cburgess5294/Arduino-Teensy/README.md

# Arduino-Teensy
Repository for files related to the Arduino-Teensy v4
