cburgess5294/Arduino-Teensy/v4.4/BOM_Arduino-Teensy-v44_PLUS_ESP-12E_4LAYER.xlsx

Designator | Manufacturer Part Number |  | Quantity
C1,C5 | EEE-1CA470SP |  | 2
C2 | TAJB106M006RNJ |  | 1
C3 | GRM188R70J103KA01D |  | 1
C6 | TAJR106M006RNJ (TANTALUM) | 08056D106KAT4A (CERAMIC) | 1
C7 | GRM188R70J104KA01D |  | 1
C8 | TMCMB0J227MTRF | F930G227MBA | 1
C9,C10 | 885012106010 |  | 2
D1,D3 | SS1P3LHM3/84A | SS1P3L-M3/84A | 2
D2 | CD1206-S01575 |  | 1
D13 | APT2012SRCPRV |  | 1
ESP-PGM,ESP-RST,HC-PGM | ADTSM62KV | PTS645SM43SMTR92 LFS | 3
F1,F2 | 0ZCJ0050FF2G |  | 2
IC1 | LM2734YMKX/NOPB |  | 1
IC2 | AP7215-33YG-13 |  | 1
L1 | MH2029-300Y |  | 1
L2 | SRR0604-100ML |  | 1
LED10,RXD1,RXD2,RXD3,TXD1,TXD2,TXD3 | APT2012SYCK |  | 7
PWR | APT2012SGC |  | 1
Q1,Q2,Q3 | BSD223PH6327XTSA1 |  | 3
Q4 | FDN340P |  | 1
R1 | RC0603JR-071KL |  | 1
R2,R4 | ESR03EZPJ103 |  | 2
R3 | RR0816P-5232-D-70C |  | 1
RESET | ADTSM62RV |  | 1
RN1,RN7 | CAT16-102J4LF |  | 2
RN3 | CAT16-103J4LFCT-ND |  | 1
RN4,RN5,RN8 | EXB-34V103JV |  | 3
RN6 | CAT16-223J4LF |  | 1
RN9 | EXB-34V223JV |  | 1
POGO-PIN | 0906-1-15-20-75-14-11-0 |  | 1
14-PIN SMD MALE HEADER | 15-91-2140 |  | 1
RTC CRYSTAL | CFS206-32.768KDZF-UB |  | 1
COIN CELL HOLDER | BAT-HLD-001 |  | 1
2.1mm barrel jack | PJ-002A |  | 1
