cburgess5294/Arduino-Teensy/Arduino-Teensy-v421_PLUS_ESP-12E.pdf

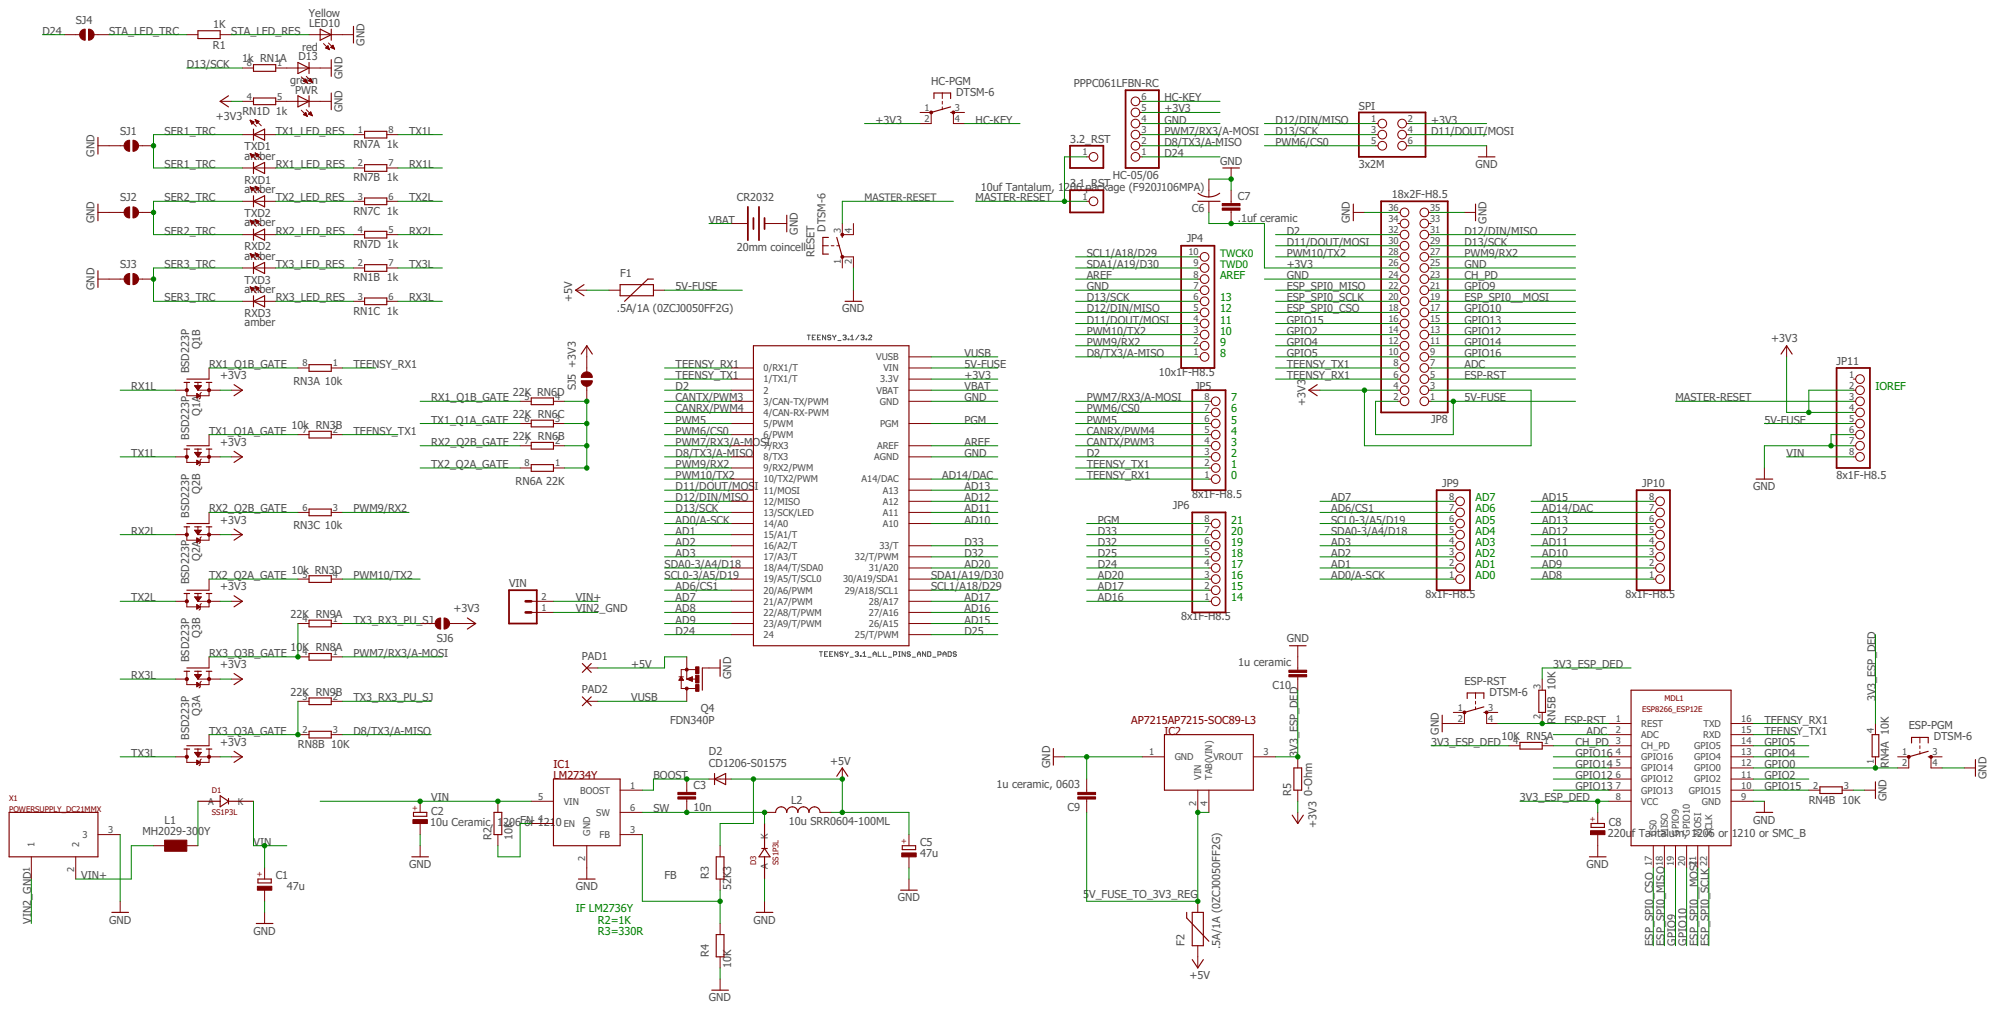
[picture p1: page 1]
