cburgess5294/Arduino-Teensy/v5/Arduino-Teensy-v51_PLUS_ESP-12E_4LAYER-BRD.pdf

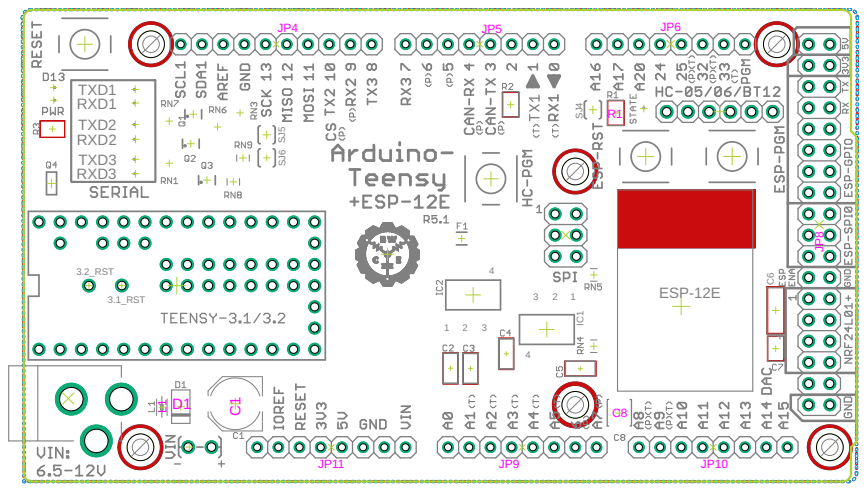
[picture p2: page 1]
