cburgess5294/Arduino-Teensy/v5/Arduino-Teensy-v51_PLUS_ESP-12E_4LAYER-SCH.pdf

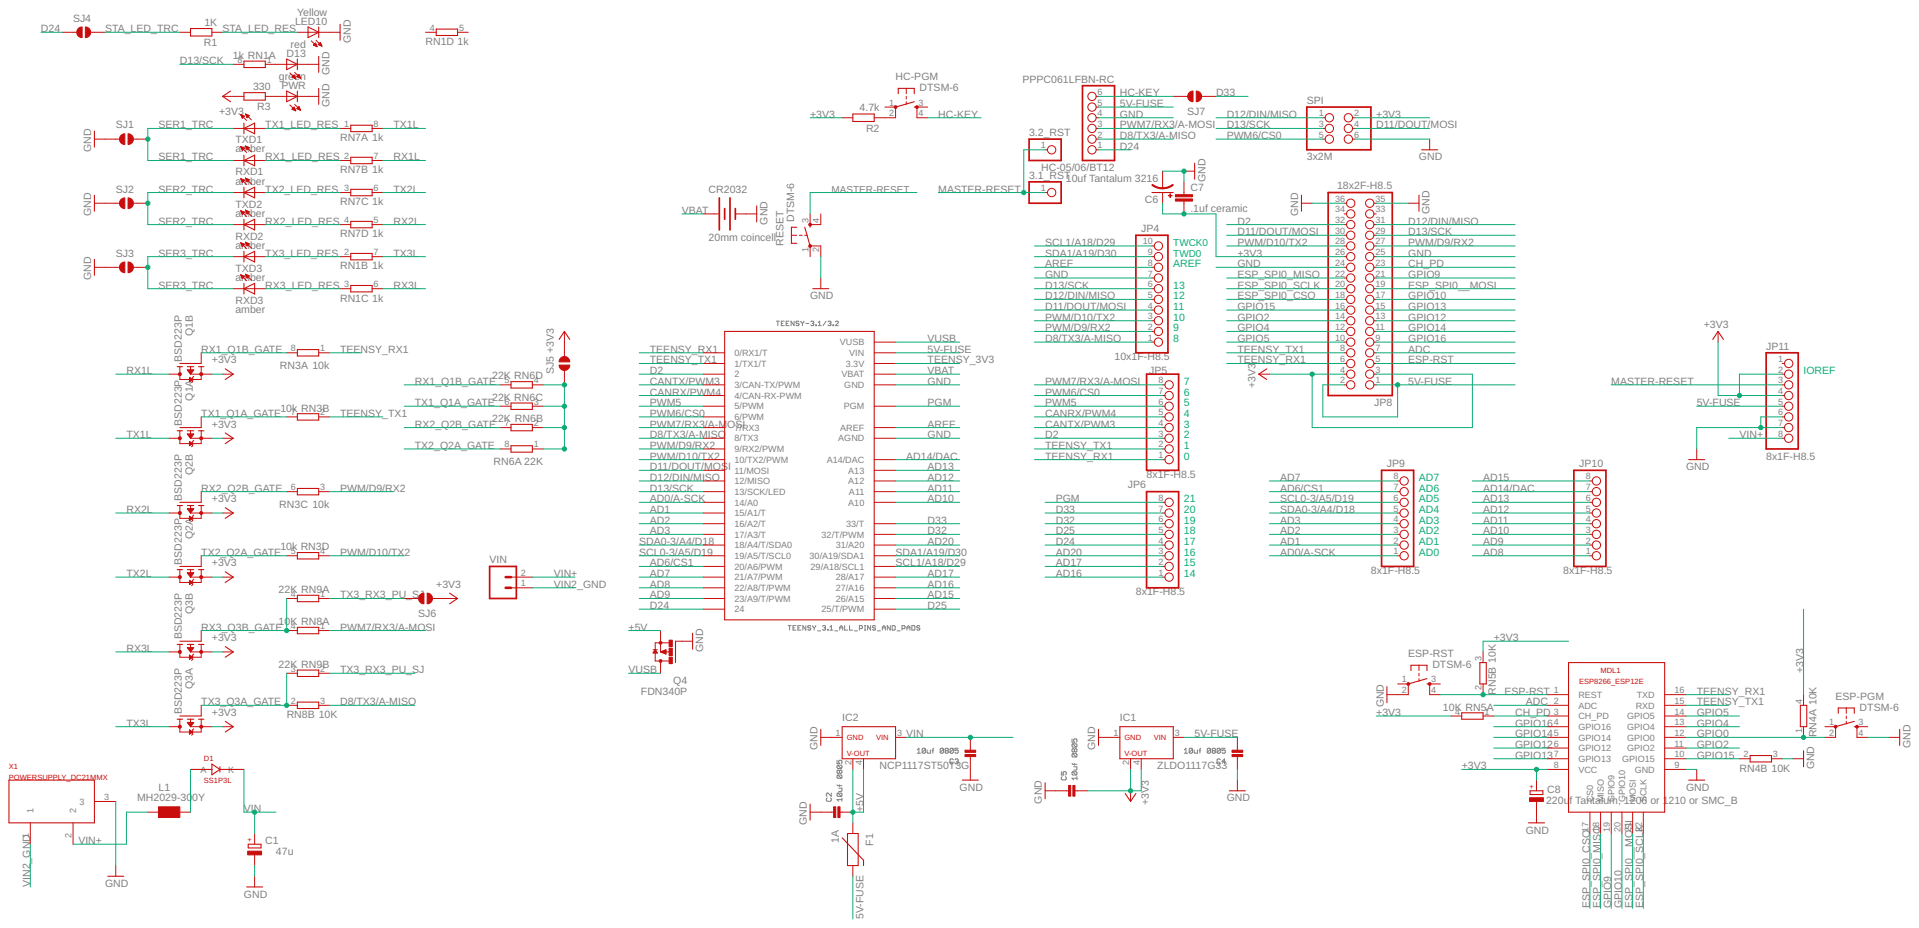
[picture p3: page 1]
