cburgess5294/Arduino-Teensy/v4.3/Arduino-Teensy-v43_PLUS_ESP-12E_BRD.pdf

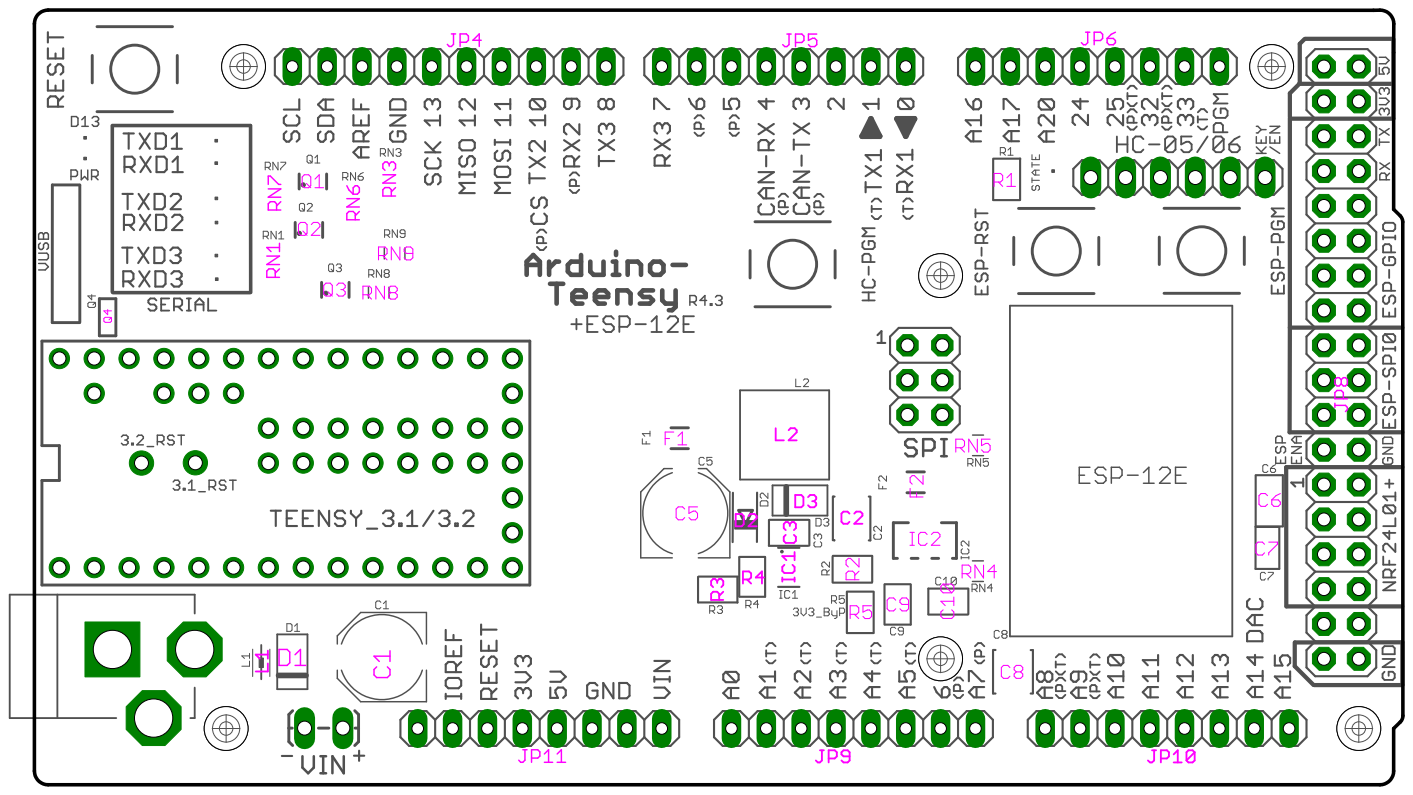
[picture p4: page 1]
