cburgess5294/Arduino-Teensy/v4.4/Arduino-Teensy-v44_PLUS_ESP-12E_4LAYER_BRD.pdf

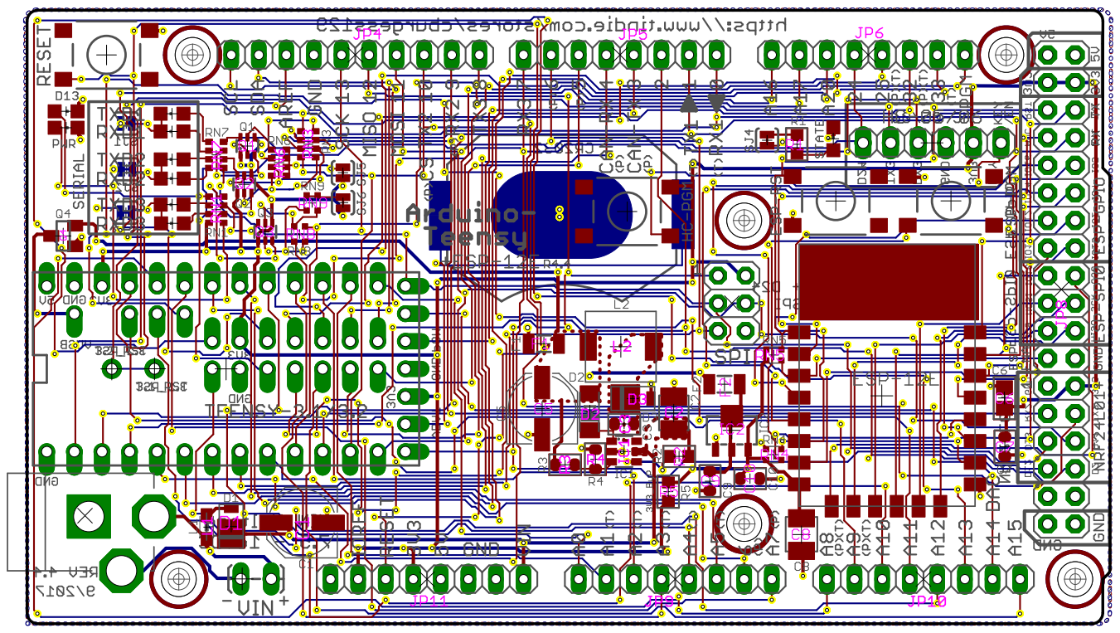
[picture p5: page 1]
