cburgess5294/Arduino-Teensy/v4.3/Arduino-Teensy-v43_PLUS_ESP-12E_SCH.pdf

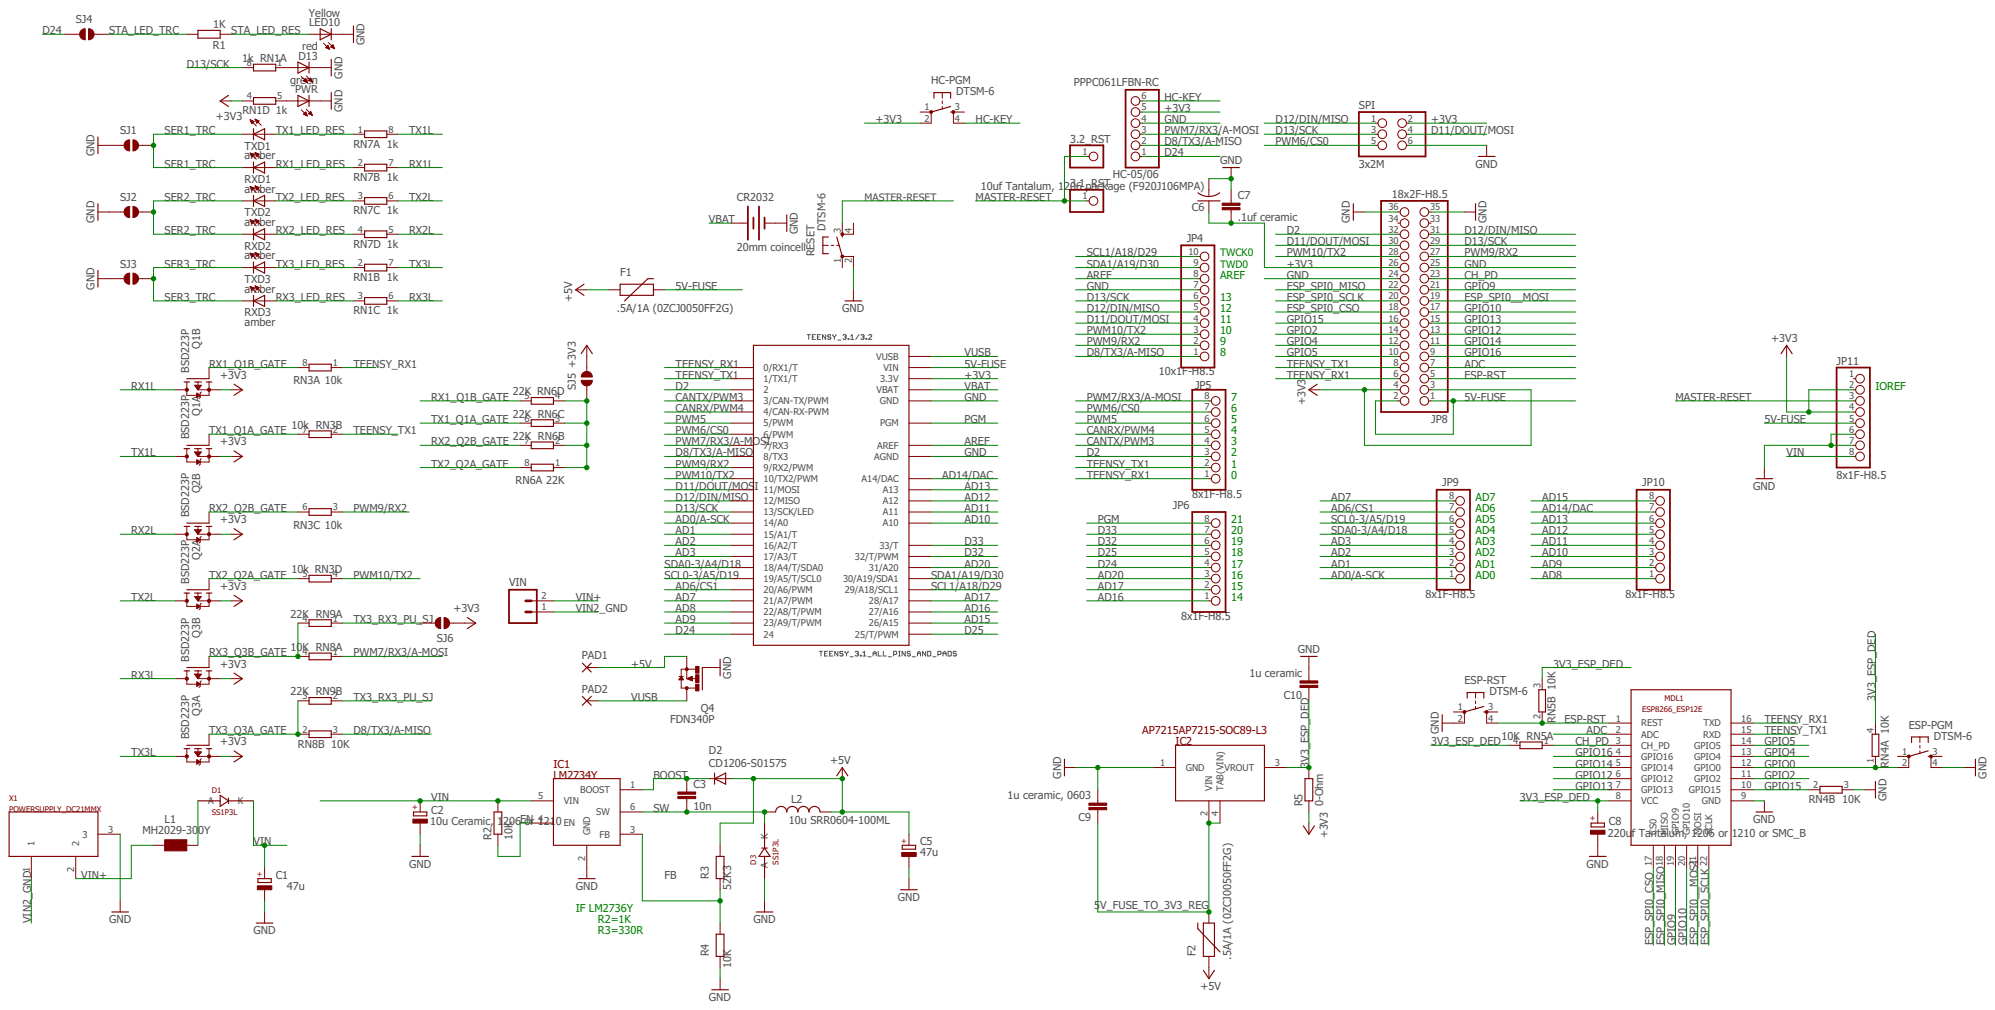
[picture p8: page 1]
