cburgess5294/Arduino-Teensy/v5/Arduino-Teensy-v5_PLUS_ESP-12E_4LAYER.brd

## EAGLE design v5/Arduino-Teensy-v5_PLUS_ESP-12E_4LAYER.brd (2019-08-05, an earlier design)

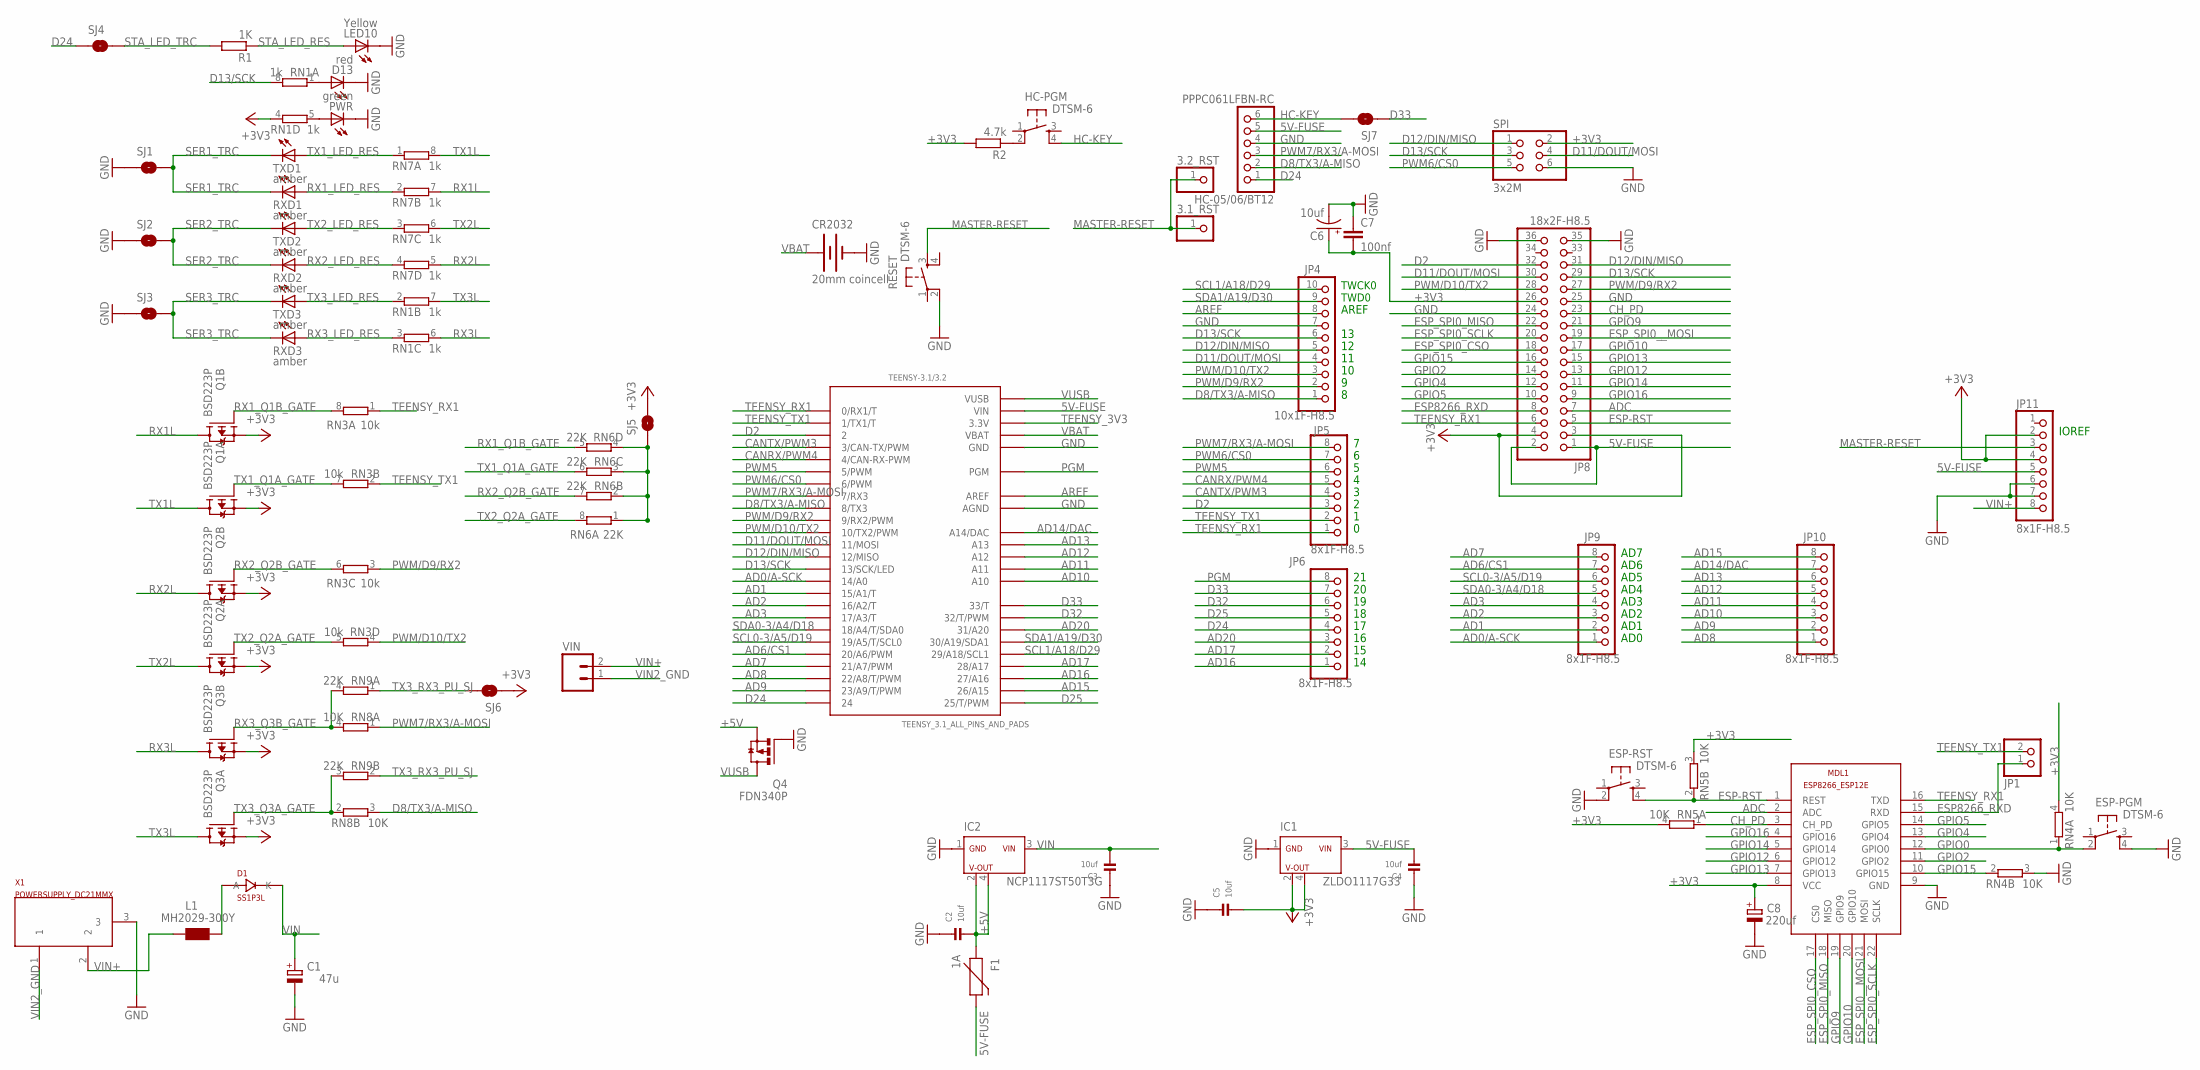
[picture p9: schematic Arduino-Teensy-v5_PLUS_ESP-12E_4LAYER.sch]

Parts:
3.1_RST, 3.2_RST: PINHD-1X1CB; 1X01-CLEANBIG
C1: 47u; PANASONIC_D
C2, C3, C4, C5: 10uf; 0805
C6: 10uf; A/3216-18R
C7: 100nf; C0603-ROUND
C8: 220uf; SMC_B
CR2032: 20mm coincell; BATTCON_20MM_4LEGS
D1: SS1P3L; DO220AAL
D13: red; CHIPLED_0805
ESP-PGM: DTSM-6
ESP-RST: DTSM-6
F1: 1A; PTC-1206
HC-05/06/BT12: PPPC061LFBN-RC; 1X06
HC-PGM: DTSM-6
IC1: ZLDO1117G33; SOT223
IC2: NCP1117ST50T3G; SOT223
JP1: PINHD-1X2; 1X02
JP4: 10x1F-H8.5; 1X10
JP5, JP6, JP9, JP10, JP11: 8x1F-H8.5; 1X08
JP8: 18x2F-H8.5; 2X18
L1: MH2029-300Y; 0805
LED10: Yellow; CHIPLED_0805
MDL1: ESP8266-12E); ESP8266-ESP12E
PWR: green; CHIPLED_0805
Q1, Q2, Q3: BSD223P; SOT363_INFINEON
Q4: FDN340P; SUPER-SOT3
R1: 1K; R0603
R2: 4.7k; R0603
RESET: DTSM-6
RN1, RN7: 1k; CAT16
RN3: 10k; CAT16
RN4, RN5, RN8: 10K; EXB34V
RN6: 22K; CAT16
RN9: 22K; EXB34V
RXD1, RXD2, RXD3: amber; CHIPLED_0805
SJ1, SJ2, SJ3, SJ4, SJ5, SJ6, SJ7: SOLDERJUMPERTRACE; SJ_2S-TRACE
SPI: 3x2M; 2X03
TEENSY-3.1/3.2: TEENSY_3.1_ALL_PINS_AND_PADS; TEENSY3_ALL_PINS_&_PADS
TXD1, TXD2, TXD3: amber; CHIPLED_0805
VIN: M02LOCK_LONGPADS; 1X02_LOCK_LONGPADS
X1: POWERSUPPLY_DC21MMX; POWERSUPPLY_DC-21MM

Connections:
5V-FUSE: C4.2, F1.2, HC-05/06/BT12.5, IC1.3 (VIN), JP8.1, JP8.2, JP11.5, TEENSY-3.1/3.2.VIN
+3V3: C5.2, C6.+, C7.2, C8.+, IC1.2 (VOUT), IC1.4 (VOUT), JP8.3, JP8.4, JP8.26, JP11.2, JP11.4, MDL1.8 (VCC), Q1.1 (S), Q1.4 (S), Q2.1 (S), Q2.4 (S), Q3.1 (S), Q3.4 (S), R2.2, RN1.4 (1), RN4.4 (2), RN5.3 (2), RN5.4 (2), SJ5.2, SJ6.1, SPI.2
+5V: C2.2, F1.1, IC2.2 (VOUT), IC2.4 (VOUT), Q4.2 (S)
AD0/A-SCK: JP9.1, TEENSY-3.1/3.2.14/A0
AD1: JP9.2, TEENSY-3.1/3.2.15/A1 (15/A1/T)
AD2: JP9.3, TEENSY-3.1/3.2.16/A2 (16/A2/T)
AD3: JP9.4, TEENSY-3.1/3.2.17/A3 (17/A3/T)
AD6/CS1: JP9.7, TEENSY-3.1/3.2.20/A6 (20/A6/PWM)
AD7: JP9.8, TEENSY-3.1/3.2.21/A7 (21/A7/PWM)
AD8: JP10.1, TEENSY-3.1/3.2.22/A8 (22/A8/T/PWM)
AD9: JP10.2, TEENSY-3.1/3.2.23/A9 (23/A9/T/PWM)
AD10: JP10.3, TEENSY-3.1/3.2.A10
AD11: JP10.4, TEENSY-3.1/3.2.A11
AD12: JP10.5, TEENSY-3.1/3.2.A12
AD13: JP10.6, TEENSY-3.1/3.2.A13
AD14/DAC: JP10.7, TEENSY-3.1/3.2.RESET/DAC (A14/DAC)
AD15: JP10.8, TEENSY-3.1/3.2.26 (26/A15)
AD16: JP6.1, TEENSY-3.1/3.2.27 (27/A16)
AD17: JP6.2, TEENSY-3.1/3.2.28 (28/A17)
AD20: JP6.3, TEENSY-3.1/3.2.31 (31/A20)
ADC: JP8.7, MDL1.2 (ADC)
AREF: JP4.8, TEENSY-3.1/3.2.AREF
CANRX/PWM4: JP5.5, TEENSY-3.1/3.2.4 (4/CAN-RX-PWM)
CANTX/PWM3: JP5.4, TEENSY-3.1/3.2.3 (3/CAN-TX/PWM)
CH_PD: JP8.23, MDL1.3 (CH_PD), RN5.1
D2: JP5.3, JP8.32, TEENSY-3.1/3.2.2
D8/TX3/A-MISO: HC-05/06/BT12.2, JP4.1, RN8.3 (2), TEENSY-3.1/3.2.8 (8/TX3)
D11/DOUT/MOSI: JP4.4, JP8.30, SPI.4, TEENSY-3.1/3.2.11 (11/MOSI)
D12/DIN/MISO: JP4.5, JP8.31, SPI.1, TEENSY-3.1/3.2.12 (12/MISO)
D13/SCK: JP4.6, JP8.29, RN1.8 (2), SPI.3, TEENSY-3.1/3.2.13 (13/SCK/LED)
D24: HC-05/06/BT12.1, JP6.4, SJ4.1, TEENSY-3.1/3.2.24
D25: JP6.5, TEENSY-3.1/3.2.25 (25/T/PWM)
D32: JP6.6, TEENSY-3.1/3.2.32 (32/T/PWM)
D33: JP6.7, SJ7.2, TEENSY-3.1/3.2.33 (33/T)
ESP8266_RXD: JP1.1, JP8.8, MDL1.15 (RXD)
ESP-RST: ESP-RST.4, JP8.5, MDL1.1 (REST), RN5.2 (1)
ESP_SPI0_CSO: JP8.18, MDL1.17 (CS0)
ESP_SPI0_MISO: JP8.22, MDL1.18 (MISO)
ESP_SPI0_SCLK: JP8.20, MDL1.22 (SCLK)
ESP_SPI0__MOSI: JP8.19, MDL1.21 (MOSI)
GND: C1.-, C2.1, C3.1, C4.1, C5.1, C6.-, C7.1, C8.-, CR2032.NEGATIVE (-), D13.C, ESP-PGM.4, ESP-RST.2, HC-05/06/BT12.4, IC1.1 (GND), IC2.1 (GND), JP4.7, JP8.24, JP8.25, JP8.35, JP8.36, JP11.6, JP11.7, LED10.C, MDL1.9 (GND), PWR.C, Q4.1 (G), RESET.2, RN4.3 (2), SJ1.1, SJ2.1, SJ3.1, SPI.6, TEENSY-3.1/3.2.AGND, TEENSY-3.1/3.2.GND, TEENSY-3.1/3.2.GND1 (GND), TEENSY-3.1/3.2.GND2 (GND), X1.3
GPIO0: ESP-PGM.2, MDL1.12 (GPIO0), RN4.1
GPIO2: JP8.14, MDL1.11 (GPIO2)
GPIO4: JP8.12, MDL1.13 (GPIO4)
GPIO5: JP8.10, MDL1.14 (GPIO5)
GPIO9: JP8.21, MDL1.19 (GPIO9)
GPIO10: JP8.17, MDL1.20 (GPIO10)
GPIO12: JP8.13, MDL1.6 (GPIO12)
GPIO13: JP8.15, MDL1.7 (GPIO13)
GPIO14: JP8.11, MDL1.5 (GPIO14)
GPIO15: JP8.16, MDL1.10 (GPIO15), RN4.2 (1)
GPIO16: JP8.9, MDL1.4 (GPIO16)
HC-KEY: HC-05/06/BT12.6, HC-PGM.4, SJ7.1
MASTER-RESET: 3.1_RST.1, 3.2_RST.1, JP11.3, RESET.3
unnamed: PWR.A, RN1.5 (2)
unnamed: D13.A, RN1.1
unnamed: HC-PGM.2, R2.1
PGM: JP6.8, TEENSY-3.1/3.2.PGM
PWM5: JP5.6, TEENSY-3.1/3.2.5 (5/PWM)
PWM6/CS0: JP5.7, SPI.5, TEENSY-3.1/3.2.6 (6/PWM)
PWM7/RX3/A-MOSI: HC-05/06/BT12.3, JP5.8, RN8.1, TEENSY-3.1/3.2.7 (7/RX3)
PWM/D9/RX2: JP4.2, JP8.27, RN3.3 (1), TEENSY-3.1/3.2.9 (9/RX2/PWM)
PWM/D10/TX2: JP4.3, JP8.28, RN3.4 (1), TEENSY-3.1/3.2.10 (10/TX2/PWM)
RX1L: Q1.3 (D), RN7.7 (2)
RX1_LED_RES: RN7.2 (1), RXD1.A
RX1_Q1B_GATE: Q1.5 (G), RN3.8 (2), RN6.5 (2)
RX1_TX1_RX2_TX2_PU_SJ: RN6.1, RN6.2 (1), RN6.3 (1), RN6.4 (1), SJ5.1
RX2L: Q2.3 (D), RN7.5 (2)
RX2_LED_RES: RN7.4 (1), RXD2.A
RX2_Q2B_GATE: Q2.5 (G), RN3.6 (2), RN6.7 (2)
RX3L: Q3.3 (D), RN1.6 (2)
RX3_LED_RES: RN1.3 (1), RXD3.A
RX3_Q3B_GATE: Q3.5 (G), RN8.4 (2), RN9.4 (2)
SCL0-3/A5/D19: JP9.6, TEENSY-3.1/3.2.19/A5 (19/A5/T/SCL0)
SCL1/A18/D29: JP4.10, TEENSY-3.1/3.2.29 (29/A18/SCL1)
SDA0-3/A4/D18: JP9.5, TEENSY-3.1/3.2.18/A4 (18/A4/T/SDA0)
SDA1/A19/D30: JP4.9, TEENSY-3.1/3.2.30 (30/A19/SDA1)
SER1_TRC: RXD1.C, SJ1.2, TXD1.C
SER2_TRC: RXD2.C, SJ2.2, TXD2.C
SER3_TRC: RXD3.C, SJ3.2, TXD3.C
STA_LED_RES: LED10.A, R1.1
STA_LED_TRC: R1.2, SJ4.2
TEENSY_3V3: TEENSY-3.1/3.2.3.3V, TEENSY-3.1/3.2.3.3V1 (3.3V), TEENSY-3.1/3.2.3.3V2 (3.3V)
TEENSY_RX1: JP5.1, JP8.6, MDL1.16 (TXD), RN3.1, TEENSY-3.1/3.2.0 (0/RX1/T)
TEENSY_TX1: JP1.2, JP5.2, RN3.2 (1), TEENSY-3.1/3.2.1 (1/TX1/T)
TX1L: Q1.6 (D), RN7.8 (2)
TX1_LED_RES: RN7.1, TXD1.A
TX1_Q1A_GATE: Q1.2 (G), RN3.7 (2), RN6.6 (2)
TX2L: Q2.6 (D), RN7.6 (2)
TX2_LED_RES: RN7.3 (1), TXD2.A
TX2_Q2A_GATE: Q2.2 (G), RN3.5 (2), RN6.8 (2)
TX3L: Q3.6 (D), RN1.7 (2)
TX3_LED_RES: RN1.2 (1), TXD3.A
TX3_Q3A_GATE: Q3.2 (G), RN8.2 (1), RN9.3 (2)
TX3_RX3_PU_SJ: RN9.1, RN9.2 (1), SJ6.2
VBAT: CR2032.POSITIVE@1 (+), CR2032.POSITIVE@2 (+), CR2032.POSITIVE@3 (+), CR2032.POSITIVE@4 (+), TEENSY-3.1/3.2.VBAT
VIN: C1.+, C3.2, D1.P$1 (K), IC2.3 (VIN)
VIN2_GND: VIN.1, X1.1
VIN+: JP11.8, L1.2, VIN.2, X1.2
VIN_FER_DIO: D1.P$2 (A), L1.1
VUSB: Q4.3 (D), TEENSY-3.1/3.2.VUSB

Notes on the sheet:
IOREF
TWCK0
TWD0
AD1
AD2
AD3
AD4
AD5
AD6
AD0
AREF
AD7

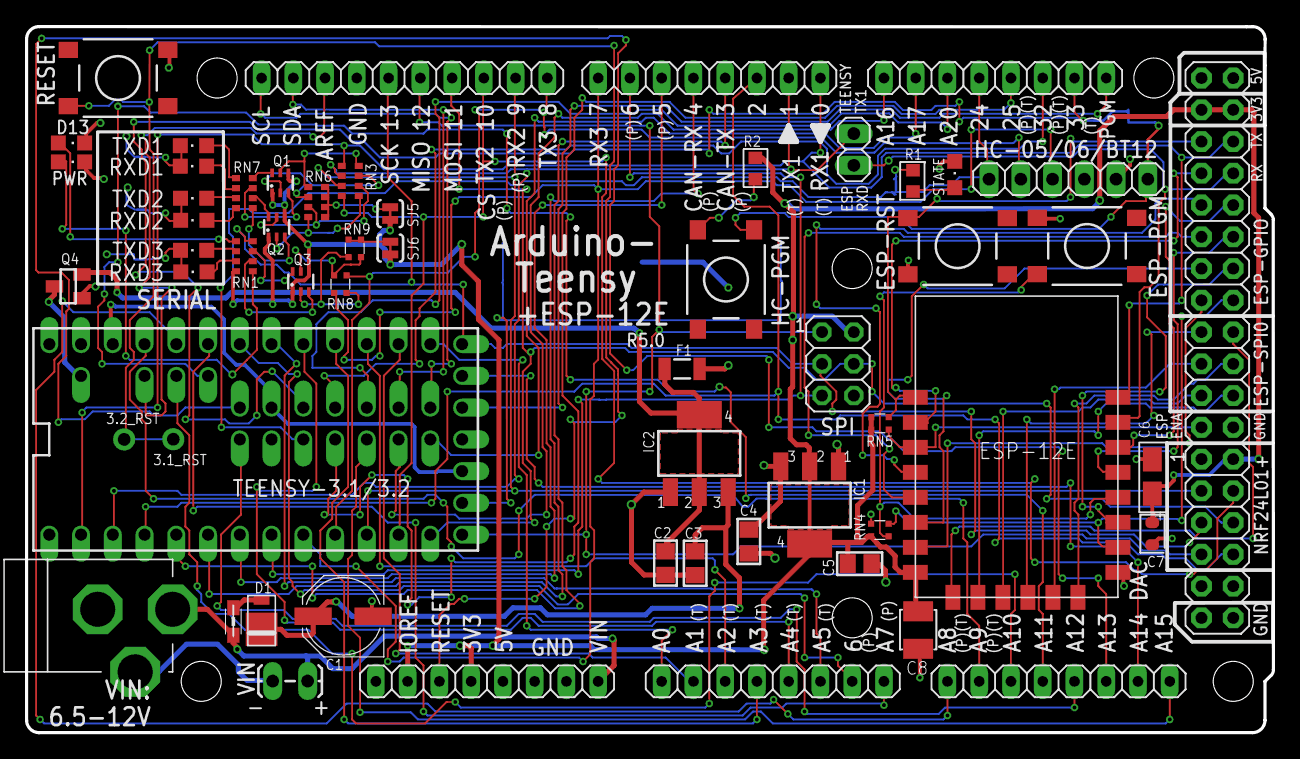
[picture p10: board Arduino-Teensy-v5_PLUS_ESP-12E_4LAYER.brd from above]

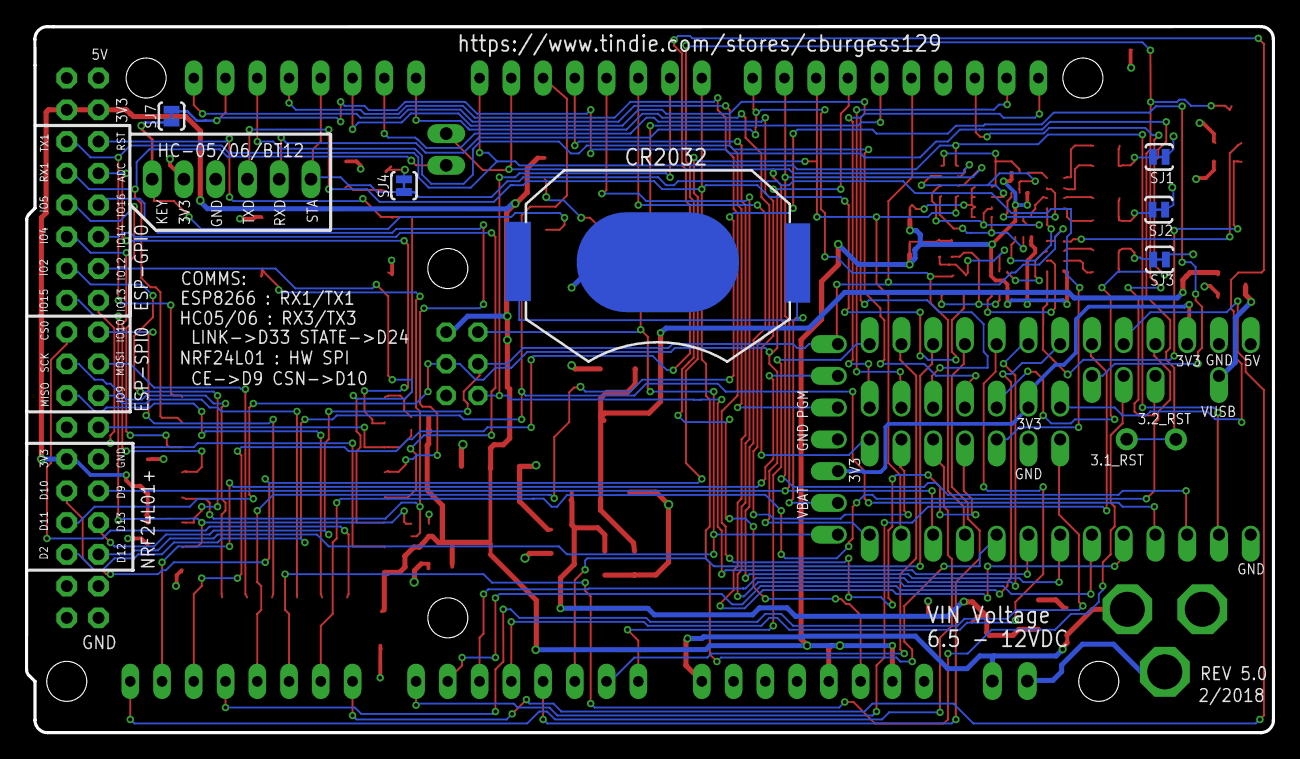
[picture p11: board Arduino-Teensy-v5_PLUS_ESP-12E_4LAYER.brd from below]

Board: 4 copper layers, 99.7 x 56.5 mm, 64 parts (6 on the bottom side), 101 nets.
