cburgess5294/Arduino-Teensy/Arduino_Teensy_test_script.ino

/*
This sketch tests the LEDs and ESP8266 on the Arduino-Teensy board.
The LEDs connected to the serial ports are active-low.  This means 
that you need to set the pinmode to OUTPUT and then use digitalwrite
to set the pin LOW in order to turn them on.  To turn them off, use
digitalwrite to set the pin HIGH, or use pinmode to set the pin to INPUT mode.
Pins D13 (built-in LED pin) and D24 (bluetooth module STATE pin) are
active-high and are turned on and off like standard LEDs.

TX1/RX1 are checked once before enabling Serial1 port due to the fact that
the Teensy does not handle disabling and re-enabling serial ports correctly.

Press the RESET button to restart the sketch.
*/
char trash = "";

void setup() {                
  //Start the USB Serial port
  Serial.begin(115200);
  Serial.println("Started");
  // initialize the digital pins as an output.
  pinMode(13, OUTPUT);  
  pinMode(24, OUTPUT);    
  Serial.println("Checking LEDs");
  
  // Check TX1 LED
  pinMode(1, OUTPUT); // set the pinmode to OUTPUT
  Serial.println("TX1");
  digitalWrite(1, LOW); //TX1 - set the pin LOW to turn on the LED
  delay(2000);  //wait 2 seconds
  digitalWrite(1, HIGH); //set the pin HIGH to turn off the LED
  pinMode(1, INPUT);  //set pinmode back to INPUT so the LED will go out without the pin being set HIGH
  
  // Check RX1 LED
  pinMode(0, OUTPUT);
  Serial.println("RX1");
  digitalWrite(0, LOW); //RX1
  delay(2000);
  digitalWrite(0, HIGH);
  pinMode(0, INPUT);
  
  // Start Serial1 port
  Serial1.begin(115200);
}

void loop() {
  // Check the TX2 LED
  Serial.println("TX2");
  pinMode(10, OUTPUT);
  digitalWrite(10, LOW); //TX2
  delay(2000);
  digitalWrite(10, HIGH);
  pinMode(10, INPUT);

  // Check the RX2 LED
  Serial.println("RX2");
  pinMode(9, OUTPUT);
  digitalWrite(9, LOW); //RX2
  delay(2000);
  digitalWrite(9, HIGH);
  pinMode(9, INPUT);

  // Check the TX3 LED
  Serial.println("TX3");
  pinMode(8, OUTPUT);
  digitalWrite(8, LOW); //TX3
  delay(2000);
  digitalWrite(8, HIGH);
  pinMode(8, INPUT);

  // Check the RX3 LED
  Serial.println("RX3");
  pinMode(7, OUTPUT);
  digitalWrite(7, LOW); //RX3
  delay(2000);
  digitalWrite(7, HIGH);
  pinMode(7, INPUT);

  // Check D13 LED (RED)
  Serial.println("D13 - built-in LED");
  digitalWrite(13, HIGH); //D13 built-in LED - Set the pin HIGH turn on the LED
  delay(2000);
  digitalWrite(13, LOW); //Set the pin LOW to turn off the LED

  // Check the Bluetooth State LED
  Serial.println("Bluetooth STATE pin");
  digitalWrite(24, HIGH); //D24 bluetooth STATE pin
  delay(2000);
  digitalWrite(24, LOW);
  
  // Check communications with the ESP8266 on TX1/RX1
  Serial.println();Serial.print("Checking ESP8266...");
  delay(500);
  Serial1.println("AT+GMR");
  if(recFind("OK", 5000)){
    Serial.println("....Success");
  }
  else{
    Serial.println("Failed");
  }
  Serial.println("Test Complete");Serial.println();
  // Clear Serial1 RX buffer
  while (Serial1.available() > 0){
    trash = Serial1.read();
  }
}

//Bool function to seach Serial RX buffer for a string value
bool recFind(String target, uint32_t timeout)
{
  char rdChar = "";
  String rdBuff = "";
  unsigned long startMillis = millis();
    while (millis() - startMillis < timeout){
      while (Serial1.available() > 0){
        rdChar = Serial1.read();
        rdBuff += rdChar;
        Serial.write(rdChar);
        if (rdBuff.indexOf(target) != -1) {
          break;
        }
     }
     if (rdBuff.indexOf(target) != -1) {
          break;
     }
   }
   if (rdBuff.indexOf(target) != -1){
    return true;
   }
   else {
    return false;
   }
}
